peiminggu/g95nc-input-controller/3d/g95nc_frame.3mf

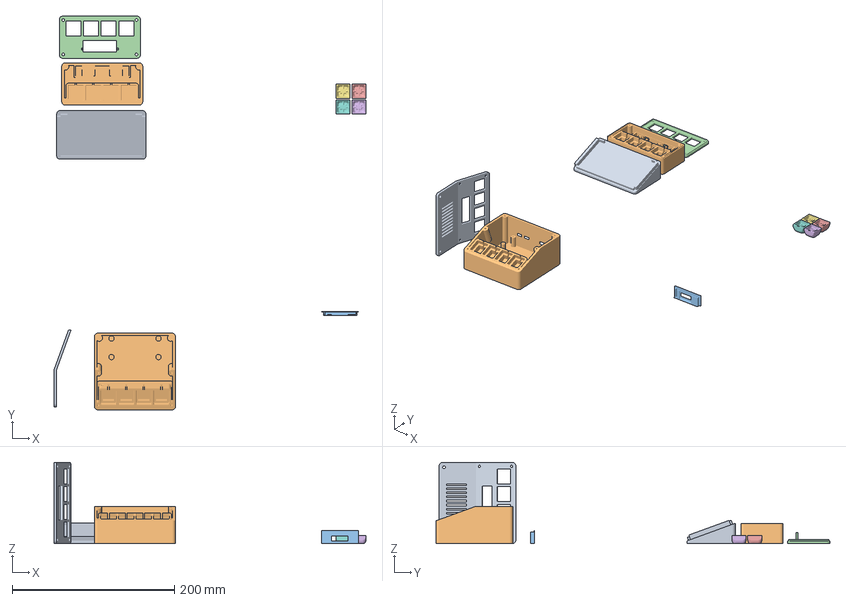
[picture p2: CAD file, 2026-10-11]
3d/g95nc_frame.3mf
385.0 x 485.8 x 100.0 mm
desktop_cradle_20deg_v1.stl
lower_frame_m3_v3.stl
oled.stl
top_cover_m3_v2.stl
H1
H2
H3
DP
unified_vented_top_cover_v5.stl
integrated_lower_body_v7.stl
