peiminggu/g95nc-input-controller/3d/v2/keycaps_A1_AMS_Lite_2color_v2.3mf

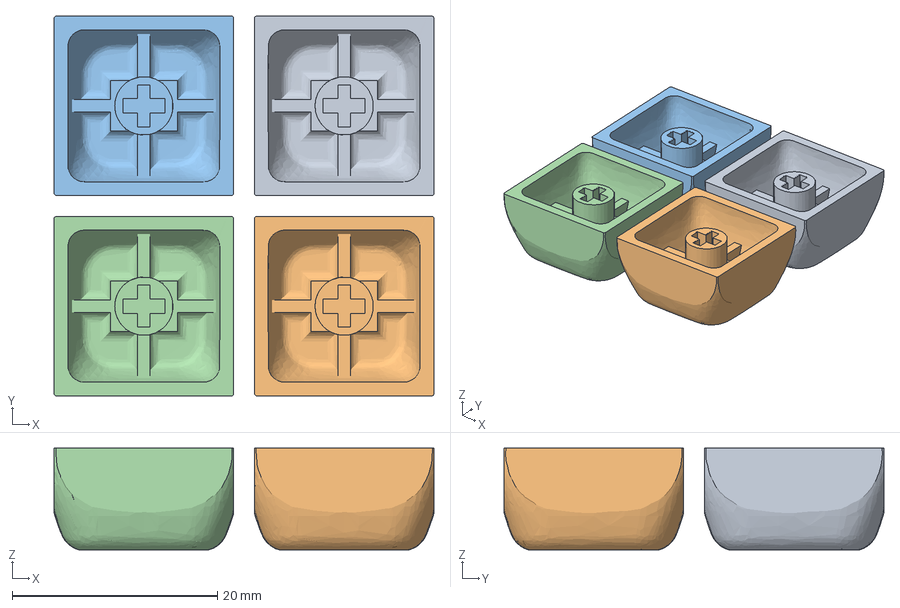
[picture p3: CAD file, 2026-10-11]
3d/v2/keycaps_A1_AMS_Lite_2color_v2.3mf
37.0 x 37.0 x 9.92 mm
H1
H2
H3
DP
