peiminggu/g95nc-input-controller/3d/v2/oled.stl

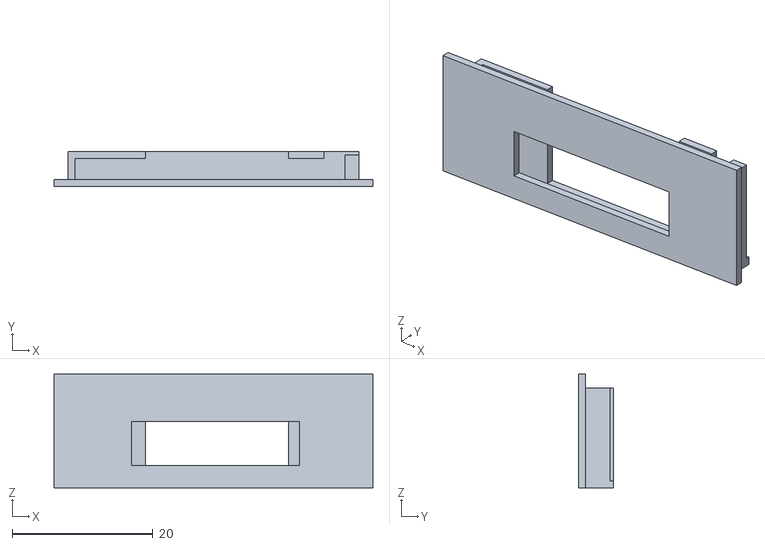
[picture p4: CAD file, 2026-10-11]
3d/v2/oled.stl
45.4 x 5.00 x 16.2
