peiminggu/g95nc-input-controller/3d/v2/unified_vented_top_cover_v7.stl

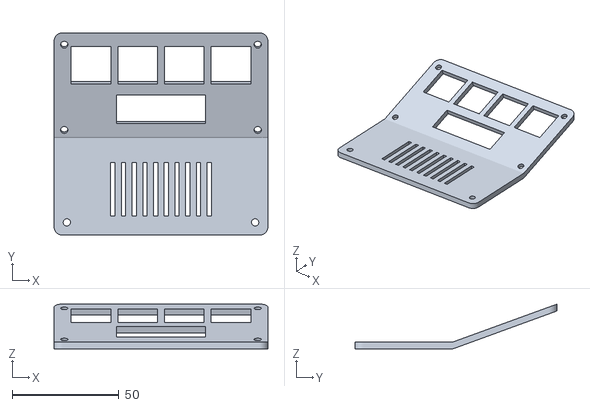
[picture p5: CAD file, 2026-10-11]
3d/v2/unified_vented_top_cover_v7.stl
100.0 x 94.6 x 21.0
