peiminggu/g95nc-input-controller/3d/v2/integrated_lower_body_v7.stl

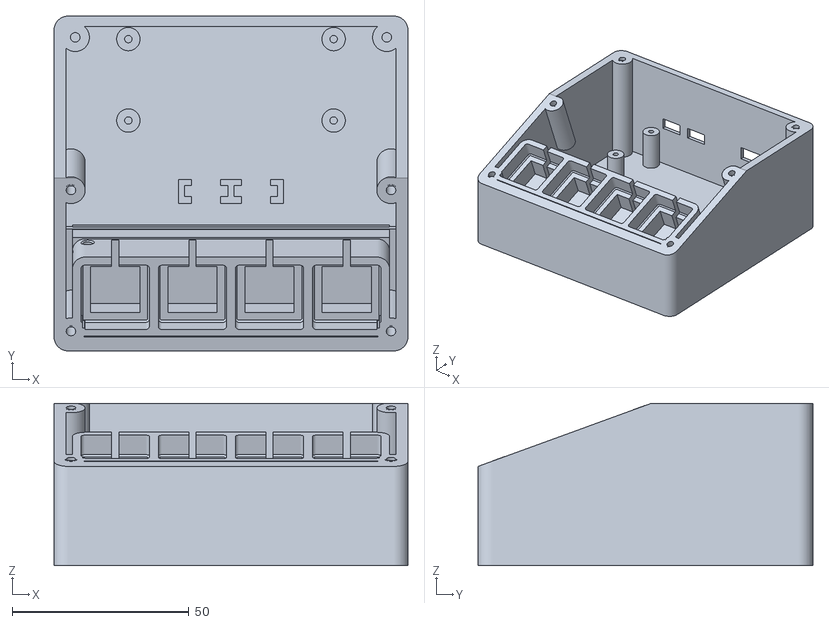
[picture p6: CAD file, 2026-10-11]
3d/v2/integrated_lower_body_v7.stl
100.0 x 94.6 x 45.9
