peiminggu/g95nc-input-controller/3d/v1/top_cover_m3_v2.stl

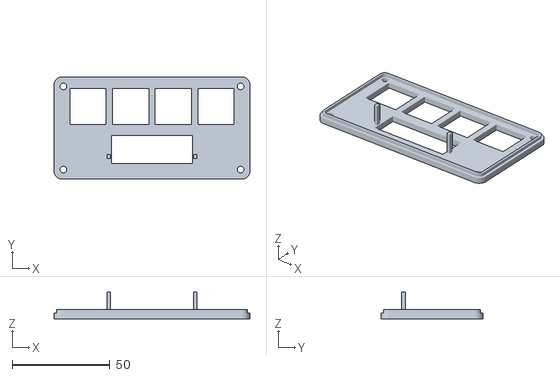
[picture p7: CAD file, 2026-10-11, an earlier design]
3d/v1/top_cover_m3_v2.stl
100.0 x 52.0 x 13.6
