peiminggu/g95nc-input-controller/3d/v1/lower_frame_m3_v3.stl

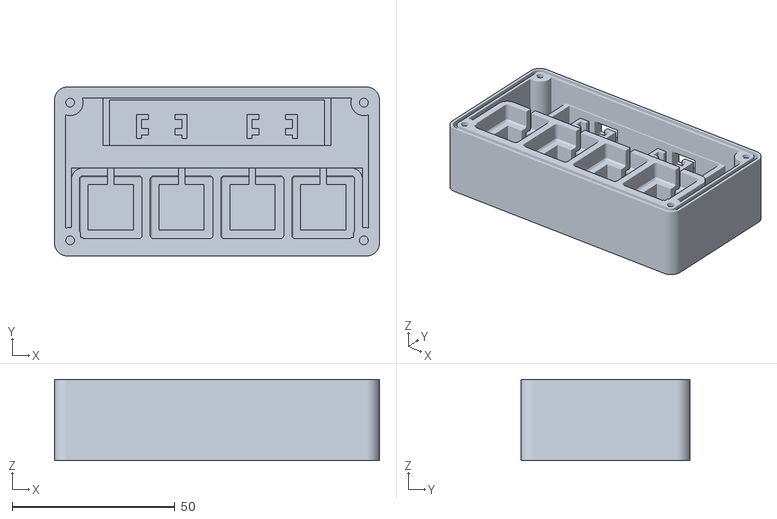
[picture p8: CAD file, 2026-10-11, an earlier design]
3d/v1/lower_frame_m3_v3.stl
100.0 x 52.0 x 25.0
