peiminggu/g95nc-input-controller/3d/v1/desktop_cradle_20deg_v1.stl

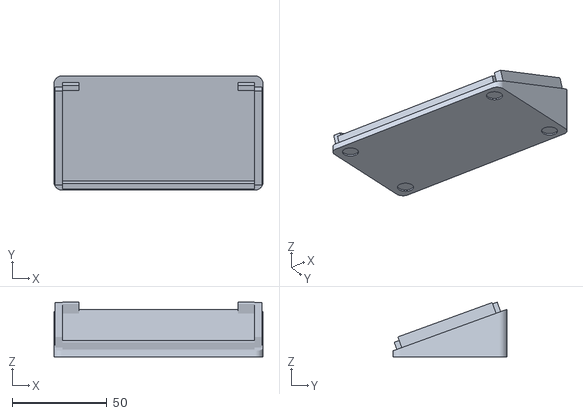
[picture p9: CAD file, 2026-10-11, an earlier design]
3d/v1/desktop_cradle_20deg_v1.stl
110.0 x 60.0 x 28.8
