peiminggu/g95nc-input-controller/(commit log)

2026-10-11 add 3d models
    [desktop_cradle_20deg_v1.stl, g95nc_frame.3mf, integrated_lower_body_v7.stl, keycaps_A1_AMS_Lite_2color_v2.3mf, lower_frame_m3_v3.stl, oled.stl, top_cover_m3_v2.stl, unified_vented_top_cover_v7.stl]
2026-10-12 disable wireless power save
